gyarab/Quadcopter-final/Schematics/controller schematic.png

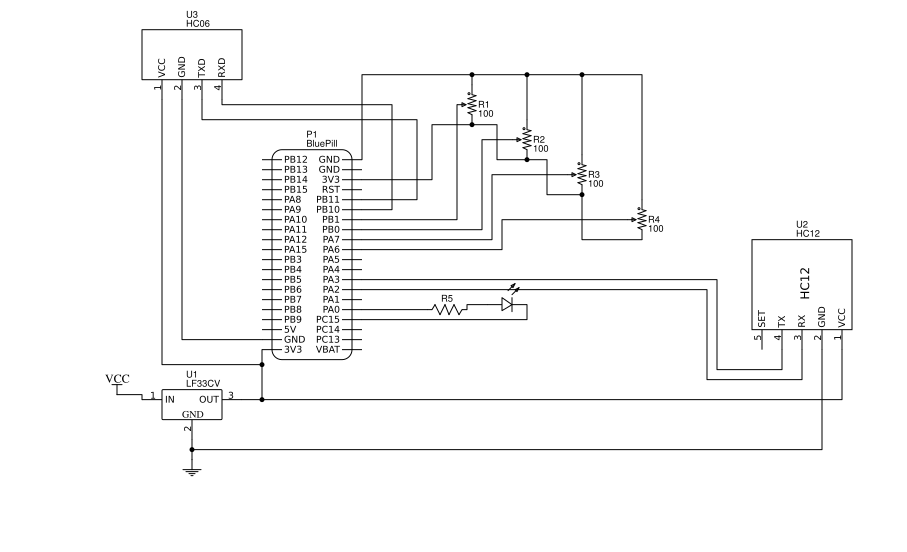
Schematics/controller schematic.png
